Pongkemon01/zeabus-elec-hydrophone-frontend/Simulation/FilterGain.asc

C1: cap; 0.022µ; V=16 Irms=21.8m Rser=9.56706 Lser=0
C2: cap; 0.022µ; V=16 Irms=21.8m Rser=9.56706 Lser=0
C3: cap; 220p; V=16 Irms=459m Rser=0.256209 Lser=0
C4: polcap; 100µ; V=6.3 Irms=150m Rser=0.85 Lser=0 mfg="Nichicon" pn="UPL0J101MAH" type="Al electrolytic"
C5: cap; 10µ; V=25 Irms=8.06 Rser=0.00577565 Lser=0 mfg="KEMET" pn="C1210C106K3PAC" type="X5R"
C6: cap; 0.022µ; V=16 Irms=21.8m Rser=9.56706 Lser=0
C7: cap; 0.022µ; V=16 Irms=21.8m Rser=9.56706 Lser=0
C8: cap; 220p; V=16 Irms=459m Rser=0.256209 Lser=0
C9: cap; 150p; V=16 Irms=459m Rser=0.256209 Lser=0
C10: cap; 150p; V=16 Irms=459m Rser=0.256209 Lser=0
C11: cap; 0.022µ; V=16 Irms=21.8m Rser=9.56706 Lser=0
C12: cap; 0.022µ; V=16 Irms=21.8m Rser=9.56706 Lser=0
C13: cap; 220p; V=16 Irms=459m Rser=0.256209 Lser=0
C14: cap; 150p; V=16 Irms=459m Rser=0.256209 Lser=0
C15: cap; 150p; V=16 Irms=459m Rser=0.256209 Lser=0
C16: cap; 150p; V=16 Irms=459m Rser=0.256209 Lser=0
C17: cap; 150p; V=16 Irms=459m Rser=0.256209 Lser=0
C18: cap; 0.022µ; V=16 Irms=21.8m Rser=9.56706 Lser=0
C19: cap; 0.022µ; V=16 Irms=21.8m Rser=9.56706 Lser=0
C20: cap; 220p; V=16 Irms=459m Rser=0.256209 Lser=0
C21: cap; 150p; V=16 Irms=459m Rser=0.256209 Lser=0
C22: cap; 150p; V=16 Irms=459m Rser=0.256209 Lser=0
R1: res; 1K; tol=1 pwr=0.1
R2: res; 1K; tol=1 pwr=0.1
R3: res; 10K; tol=1 pwr=0.1
R4: res; 10K; tol=1 pwr=0.1
R5: res; 10K; tol=1 pwr=0.1
R6: res; 10K; tol=1 pwr=0.1
R7: res; 1K; tol=1 pwr=0.1
R8: res; 1K; tol=1 pwr=0.1
R9: res; 1K; tol=1 pwr=0.1
R10: res; 10K; tol=1 pwr=0.1
R11: res; 1K; tol=1 pwr=0.1
R12: res; 1K; tol=1 pwr=0.1
R13: res; 10K; tol=1 pwr=0.1
R14: res; 10K; tol=1 pwr=0.1
R15: res; 1K; tol=1 pwr=0.1
R16: res; 1K; tol=1 pwr=0.1
R17: res; 1K; tol=1 pwr=0.1
R18: res; 10K; tol=1 pwr=0.1
R19: res; 680; tol=1 pwr=0.1
R20: res; 1000K
R21: res; 1K; tol=1 pwr=0.1
R22: res; 1K; tol=1 pwr=0.1
R23: res; 10K; tol=1 pwr=0.1
R24: res; 10K; tol=1 pwr=0.1
R25: res; 1K; tol=1 pwr=0.1
R26: res; 1K; tol=1 pwr=0.1
R27: res; 680; tol=1 pwr=0.1
R28: res; 1000K
R29: res; 1K; tol=1 pwr=0.1
R30: res; 10K; tol=1 pwr=0.1
R31: res; 680; tol=1 pwr=0.1
R32: res; 1000K
R33: res; 1K; tol=1 pwr=0.1
R34: res; 1K; tol=1 pwr=0.1
R35: res; 10K; tol=1 pwr=0.1
R36: res; 10K; tol=1 pwr=0.1
R37: res; 1K; tol=1 pwr=0.1
R38: res; 1K; tol=1 pwr=0.1
R39: res; 1K; tol=1 pwr=0.1
R40: res; 10K; tol=1 pwr=0.1
R41: res; 680; tol=1 pwr=0.1
R42: res; 1000K
U1: AD8092
U2: AD8092
U3: AD8092
U4: AD8092
U5: AD8092
U6: AD8092
U7: AD8092
U8: AD8092
V1: voltage; 5
V2: voltage; ""; AC 1
V3: voltage; ""; AC 1
V4: voltage; ""; AC 1
V5: voltage; ""; AC 1
Named nets: 0, Vcc, Vref
.ac dec 100 1k 1000k
