Pongkemon01/zeabus-elec-hydrophone-frontend/zeabus-elec-hydrophone-frontend.kicad_pcb

## KiCad design zeabus-elec-hydrophone-frontend.kicad_pcb (2018-04-28)

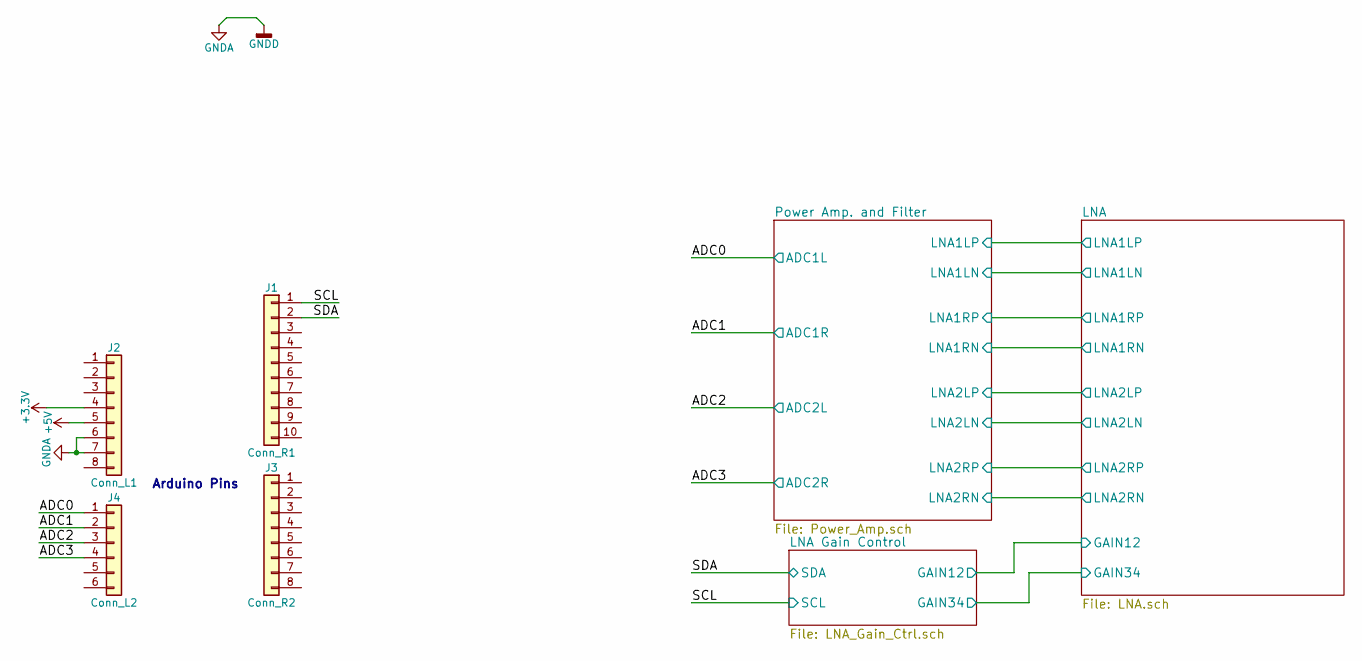
[picture p1: schematic zeabus-elec-hydrophone-frontend.sch, Main Sheet]

Parts:
J1: Conn_R1; Pin_Header_Straight_1x10_Pitch2.54mm
J2: Conn_L1; Pin_Header_Straight_1x08_Pitch2.54mm
J3: Conn_R2; Pin_Header_Straight_1x08_Pitch2.54mm
J4: Conn_L2; Pin_Header_Straight_1x06_Pitch2.54mm

Connections:
+3V3: J2.4; also elsewhere on the board
+5V: J2.5; also elsewhere on the board
/ADC0: J4.1; also elsewhere on the board
/ADC1: J4.2; also elsewhere on the board
/ADC2: J4.3; also elsewhere on the board
/ADC3: J4.4; also elsewhere on the board
/SCL: J1.1; also elsewhere on the board
/SDA: J1.2; also elsewhere on the board
GNDA: J2.6, J2.7; also elsewhere on the board

Notes on the sheet:
Arduino Pins

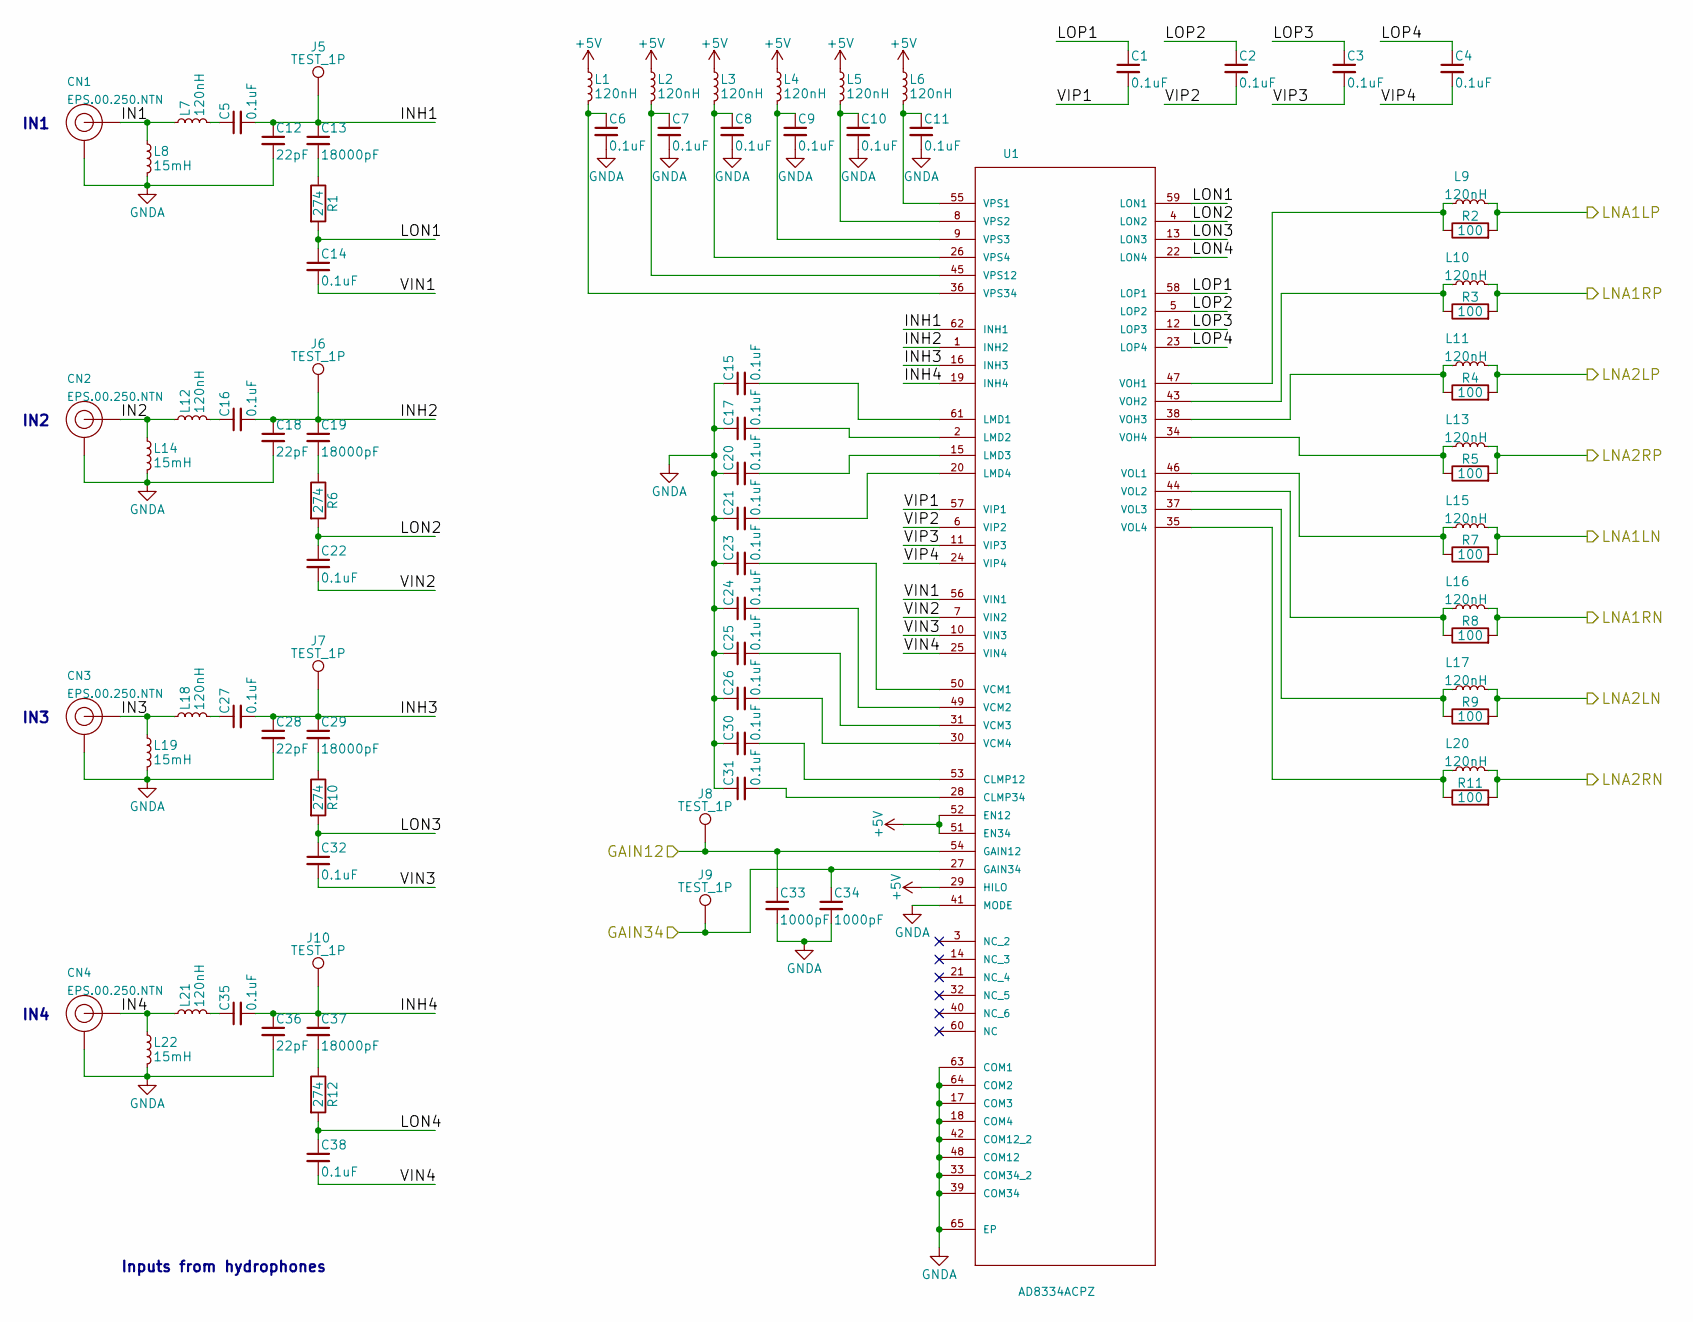
[picture p2: schematic LNA.sch]

Parts:
C1, C2, C3, C4, C5, C6, C7, C8, C9, C10, C11, C14, C15, C16, C17, C20, C21, C22, C23, C24, C25, C26, C27, C30, C31, C32, C35, C38: 0.1uF; C_0603_HandSoldering
C12, C18, C28, C36: 22pF; C_0603_HandSoldering
C13, C19, C29, C37: 18000pF; C_0603_HandSoldering
C33, C34: 1000pF; C_0603_HandSoldering
CN1, CN2, CN3, CN4: EPS.00.250.NTN; EPS-00-250
J5, J6, J7, J8, J9, J10: TEST_1P; Pin_Header_Straight_1x01_Pitch2.54mm
L1, L2, L3, L4, L5, L6, L7, L9, L10, L11, L12, L13, L15, L16, L17, L18, L20, L21: 120nH; L_0603_HandSoldering
L8, L14, L19, L22: 15mH; L-SDR0503
R1, R6, R10, R12: 274; R_0603_HandSoldering
R2, R3, R4, R5, R7, R8, R9, R11: 100; R_0603_HandSoldering
U1: AD8334ACPZ; QFN50P900X900X100-65N

Connections:
+5V: L1.1, L2.1, L3.1, L4.1, L5.1, L6.1, U1.29 (HILO), U1.51 (EN34), U1.52 (EN12); also elsewhere on the board
/LNA Gain Control/GAIN12: C33.1, J8.1, U1.54 (GAIN12); also elsewhere on the board
/LNA Gain Control/GAIN34: C34.1, J9.1, U1.27 (GAIN34); also elsewhere on the board
/LNA/IN1: CN1.1 (OUT), L7.1, L8.1
/LNA/IN2: CN2.1 (OUT), L12.1, L14.1
/LNA/IN3: CN3.1 (OUT), L18.1, L19.1
/LNA/IN4: CN4.1 (OUT), L21.1, L22.1
/LNA/INH1: C5.2, C12.1, C13.1, J5.1, U1.62 (INH1)
/LNA/INH2: C16.2, C18.1, C19.1, J6.1, U1.1 (INH2)
/LNA/INH3: C27.2, C28.1, C29.1, J7.1, U1.16 (INH3)
/LNA/INH4: C35.2, C36.1, C37.1, J10.1, U1.19 (INH4)
/LNA/LNA1LN: L15.2, R7.2; also elsewhere on the board
/LNA/LNA1LP: L9.2, R2.2; also elsewhere on the board
/LNA/LNA1RN: L16.2, R8.2; also elsewhere on the board
/LNA/LNA1RP: L10.2, R3.2; also elsewhere on the board
/LNA/LNA2LN: L17.2, R9.2; also elsewhere on the board
/LNA/LNA2LP: L11.2, R4.2; also elsewhere on the board
/LNA/LNA2RN: L20.2, R11.2; also elsewhere on the board
/LNA/LNA2RP: L13.2, R5.2; also elsewhere on the board
/LNA/LON1: C14.1, R1.2, U1.59 (LON1)
/LNA/LON2: C22.1, R6.2, U1.4 (LON2)
/LNA/LON3: C32.1, R10.2, U1.13 (LON3)
/LNA/LON4: C38.1, R12.2, U1.22 (LON4)
/LNA/LOP1: C1.1, U1.58 (LOP1)
/LNA/LOP2: C2.1, U1.5 (LOP2)
/LNA/LOP3: C3.1, U1.12 (LOP3)
/LNA/LOP4: C4.1, U1.23 (LOP4)
/LNA/VIN1: C14.2, U1.56 (VIN1)
/LNA/VIN2: C22.2, U1.7 (VIN2)
/LNA/VIN3: C32.2, U1.10 (VIN3)
/LNA/VIN4: C38.2, U1.25 (VIN4)
/LNA/VIP1: C1.2, U1.57 (VIP1)
/LNA/VIP2: C2.2, U1.6 (VIP2)
/LNA/VIP3: C3.2, U1.11 (VIP3)
/LNA/VIP4: C4.2, U1.24 (VIP4)
GNDA: C6.2, C7.2, C8.2, C9.2, C10.2, C11.2, C12.2, C15.1, C17.1, C18.2, C20.1, C21.1, C23.1, C24.1, C25.1, C26.1, C28.2, C30.1, C31.1, C33.2, C34.2, C36.2, CN1.2 (GND), CN1.3 (GND), CN1.4 (GND), CN1.5 (GND), CN2.2 (GND), CN2.3 (GND), CN2.4 (GND), CN2.5 (GND), CN3.2 (GND), CN3.3 (GND), CN3.4 (GND), CN3.5 (GND), CN4.2 (GND), CN4.3 (GND), CN4.4 (GND), CN4.5 (GND), L8.2, L14.2, L19.2, L22.2, U1.17 (COM3), U1.18 (COM4), U1.33 (COM34_2), U1.39 (COM34), U1.41 (MODE), U1.42 (COM12_2), U1.48 (COM12), U1.63 (COM1), U1.64 (COM2), U1.65 (EP); also elsewhere on the board
unnamed: C5.1, L7.2
unnamed: C6.1, L1.2, U1.36 (VPS34)
unnamed: C7.1, L2.2, U1.45 (VPS12)
unnamed: C8.1, L3.2, U1.26 (VPS4)
unnamed: C9.1, L4.2, U1.9 (VPS3)
unnamed: C10.1, L5.2, U1.8 (VPS2)
unnamed: C11.1, L6.2, U1.55 (VPS1)
unnamed: C13.2, R1.1
unnamed: C15.2, U1.61 (LMD1)
unnamed: C16.1, L12.2
unnamed: C17.2, U1.2 (LMD2)
unnamed: C19.2, R6.1
unnamed: C20.2, U1.15 (LMD3)
unnamed: C21.2, U1.20 (LMD4)
unnamed: C23.2, U1.50 (VCM1)
unnamed: C24.2, U1.49 (VCM2)
unnamed: C25.2, U1.31 (VCM3)
unnamed: C26.2, U1.30 (VCM4)
unnamed: C27.1, L18.2
unnamed: C29.2, R10.1
unnamed: C30.2, U1.53 (CLMP12)
unnamed: C31.2, U1.28 (CLMP34)
unnamed: C35.1, L21.2
unnamed: C37.2, R12.1
unnamed: L9.1, R2.1, U1.47 (VOH1)
unnamed: L10.1, R3.1, U1.43 (VOH2)
unnamed: L11.1, R4.1, U1.38 (VOH3)
unnamed: L13.1, R5.1, U1.34 (VOH4)
unnamed: L15.1, R7.1, U1.46 (VOL1)
unnamed: L16.1, R8.1, U1.44 (VOL2)
unnamed: L17.1, R9.1, U1.37 (VOL3)
unnamed: L20.1, R11.1, U1.35 (VOL4)

Notes on the sheet:
IN1
IN2
IN3
IN4
Inputs from hydrophones

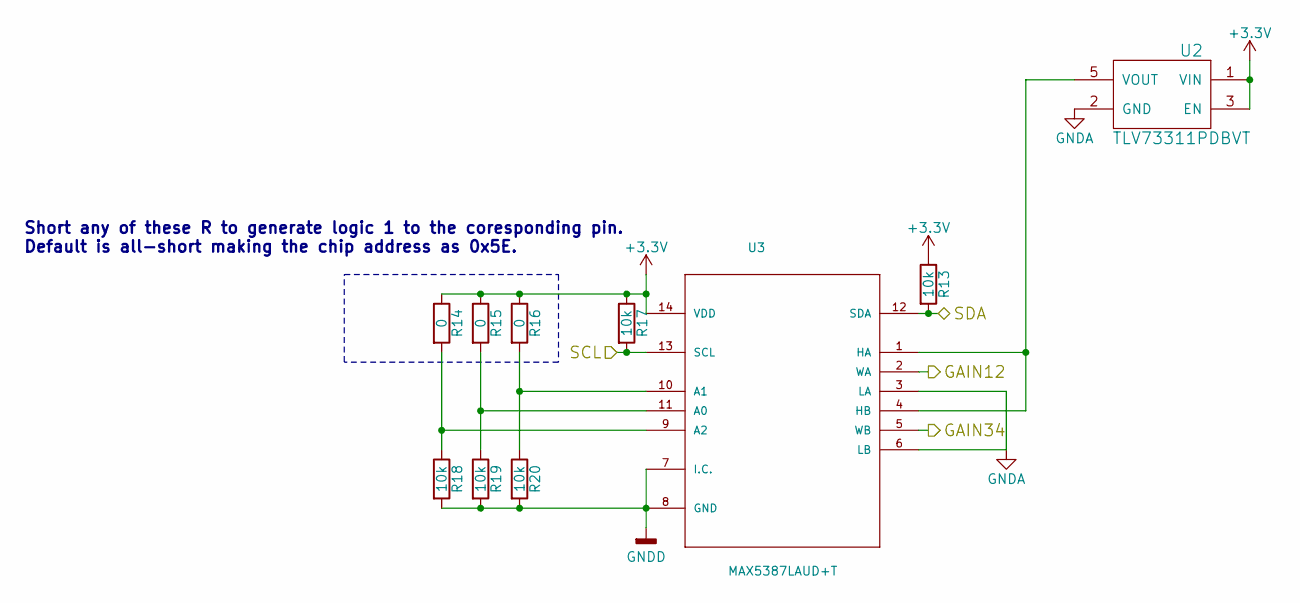
[picture p3: schematic LNA_Gain_Ctrl.sch, LNA Gain Controller]

Parts:
R13, R17, R18, R19, R20: 10k; R_0603_HandSoldering
R14, R15, R16: 0; R_0603_HandSoldering
U2: TLV73311PDBVT; SOT-23-5
U3: MAX5387LAUD+T; TSSOP-14_4.4x5mm_Pitch0.65mm

Connections:
+3V3: R13.1, R14.1, R15.1, R16.1, R17.1, U2.1 (VIN), U2.3 (EN), U3.14 (VDD); also elsewhere on the board
/LNA Gain Control/GAIN12: U3.2 (WA); also elsewhere on the board
/LNA Gain Control/GAIN34: U3.5 (WB); also elsewhere on the board
/SCL: R17.2, U3.13 (SCL); also elsewhere on the board
/SDA: R13.2, U3.12 (SDA); also elsewhere on the board
GNDA: R18.2, R19.2, R20.2, U2.2 (GND), U3.3 (LA), U3.6 (LB), U3.7 (I.C.), U3.8 (GND); also elsewhere on the board
unnamed: R14.2, R18.1, U3.9 (A2)
unnamed: R15.2, R19.1, U3.11 (A0)
unnamed: R16.2, R20.1, U3.10 (A1)
unnamed: U2.5 (VOUT), U3.1 (HA), U3.4 (HB)

Notes on the sheet:
Short any of these R to generate logic 1 to the coresponding pin. Default is all-short making the chip address as 0x5E.

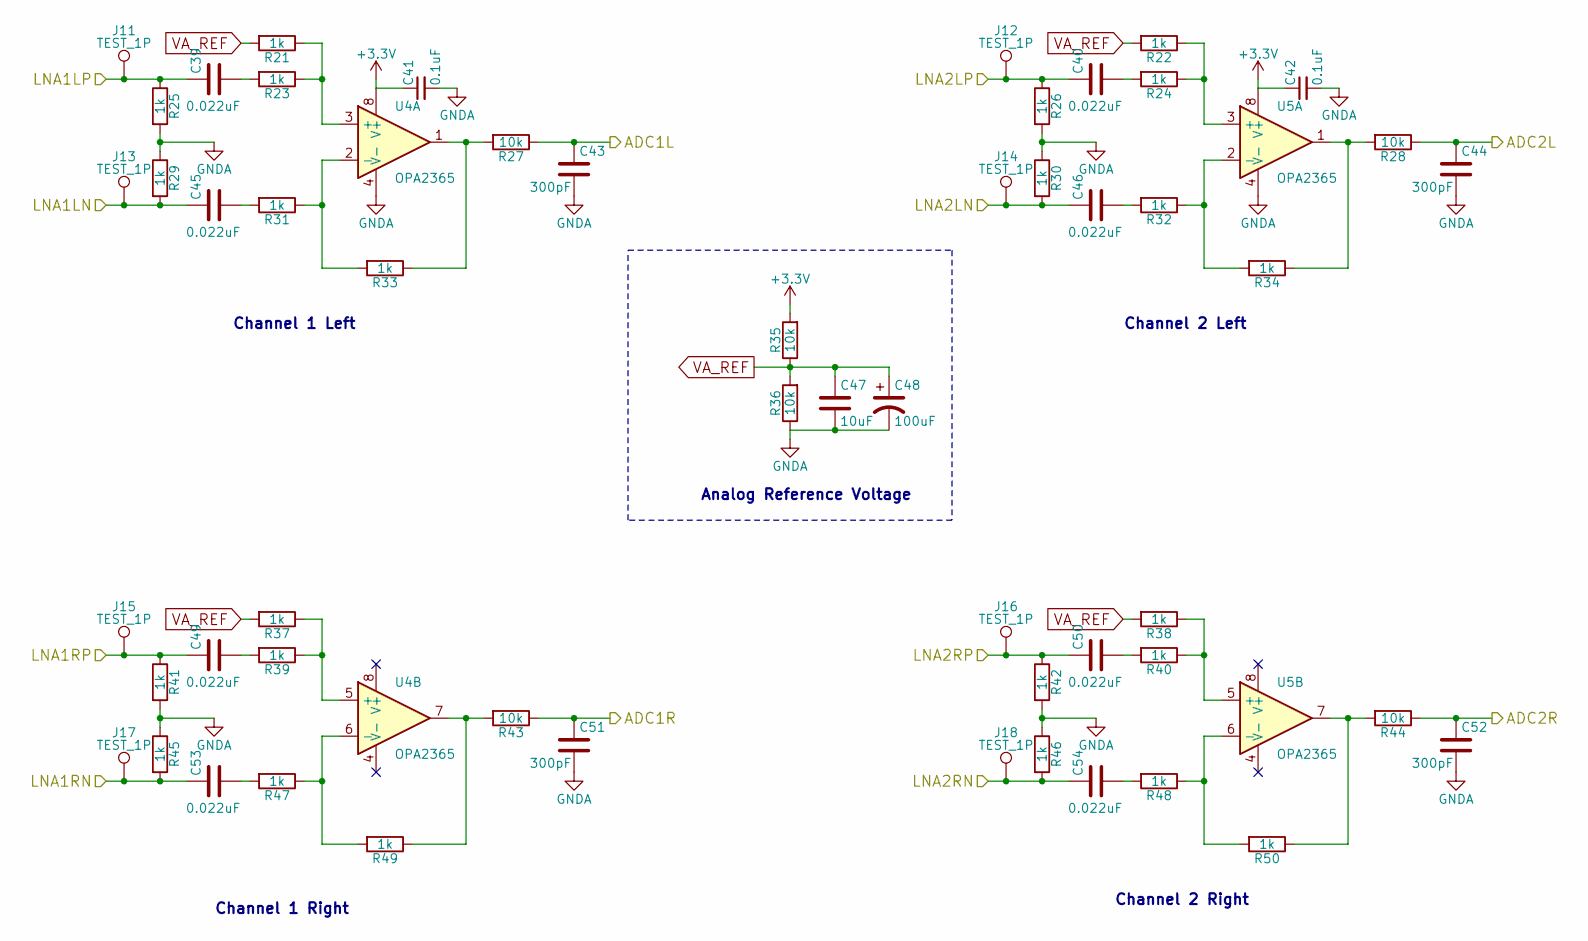
[picture p4: schematic Power_Amp.sch]

Parts:
C39, C40, C45, C46, C49, C50, C53, C54: 0.022uF; C_0603_HandSoldering
C41, C42: 0.1uF; C_0603_HandSoldering
C43, C44, C51, C52: 300pF; C_0603_HandSoldering
C47: 10uF; C_0805_HandSoldering
C48: 100uF; C_1210_HandSoldering
J11, J12, J13, J14, J15, J16, J17, J18: TEST_1P; Pin_Header_Straight_1x01_Pitch2.54mm
R21, R22, R23, R24, R25, R26, R29, R30, R31, R32, R33, R34, R37, R38, R39, R40, R41, R42, R45, R46, R47, R48, R49, R50: 1k; R_0603_HandSoldering
R27, R28, R35, R36, R43, R44: 10k; R_0603_HandSoldering
U4, U5: OPA2365; SOIC-8_3.9x4.9mm_Pitch1.27mm

Connections:
+3V3: C41.1, C42.1, R35.2, U4.8 (V+), U5.8 (V+); also elsewhere on the board
/ADC0: C43.1, R27.1; also elsewhere on the board
/ADC1: C51.1, R43.1; also elsewhere on the board
/ADC2: C44.1, R28.1; also elsewhere on the board
/ADC3: C52.1, R44.1; also elsewhere on the board
/LNA/LNA1LN: C45.1, J13.1, R29.2; also elsewhere on the board
/LNA/LNA1LP: C39.1, J11.1, R25.1; also elsewhere on the board
/LNA/LNA1RN: C53.1, J17.1, R45.2; also elsewhere on the board
/LNA/LNA1RP: C49.1, J15.1, R41.1; also elsewhere on the board
/LNA/LNA2LN: C46.1, J14.1, R30.2; also elsewhere on the board
/LNA/LNA2LP: C40.1, J12.1, R26.1; also elsewhere on the board
/LNA/LNA2RN: C54.1, J18.1, R46.2; also elsewhere on the board
/LNA/LNA2RP: C50.1, J16.1, R42.1; also elsewhere on the board
GNDA: C41.2, C42.2, C43.2, C44.2, C47.2, C48.2, C51.2, C52.2, R25.2, R26.2, R29.1, R30.1, R36.1, R41.2, R42.2, R45.1, R46.1, U4.4 (V-), U5.4 (V-); also elsewhere on the board
unnamed: C39.2, R23.2
unnamed: C40.2, R24.2
unnamed: C45.2, R31.2
unnamed: C46.2, R32.2
unnamed: C49.2, R39.2
unnamed: C50.2, R40.2
unnamed: C53.2, R47.2
unnamed: C54.2, R48.2
unnamed: R21.1, R23.1, U4.3 (+)
unnamed: R22.1, R24.1, U5.3 (+)
unnamed: R27.2, R33.1, U4.1
unnamed: R28.2, R34.1, U5.1
unnamed: R31.1, R33.2, U4.2 (-)
unnamed: R32.1, R34.2, U5.2 (-)
unnamed: R37.1, R39.1, U4.5 (+)
unnamed: R38.1, R40.1, U5.5 (+)
unnamed: R43.2, R49.1, U4.7
unnamed: R44.2, R50.1, U5.7
unnamed: R47.1, R49.2, U4.6 (-)
unnamed: R48.1, R50.2, U5.6 (-)
VA_REF: C47.1, C48.1, R21.2, R22.2, R35.1, R36.2, R37.2, R38.2

Notes on the sheet:
Analog Reference Voltage
Channel 1 Left
Channel 1 Right
Channel 2 Left
Channel 2 Right

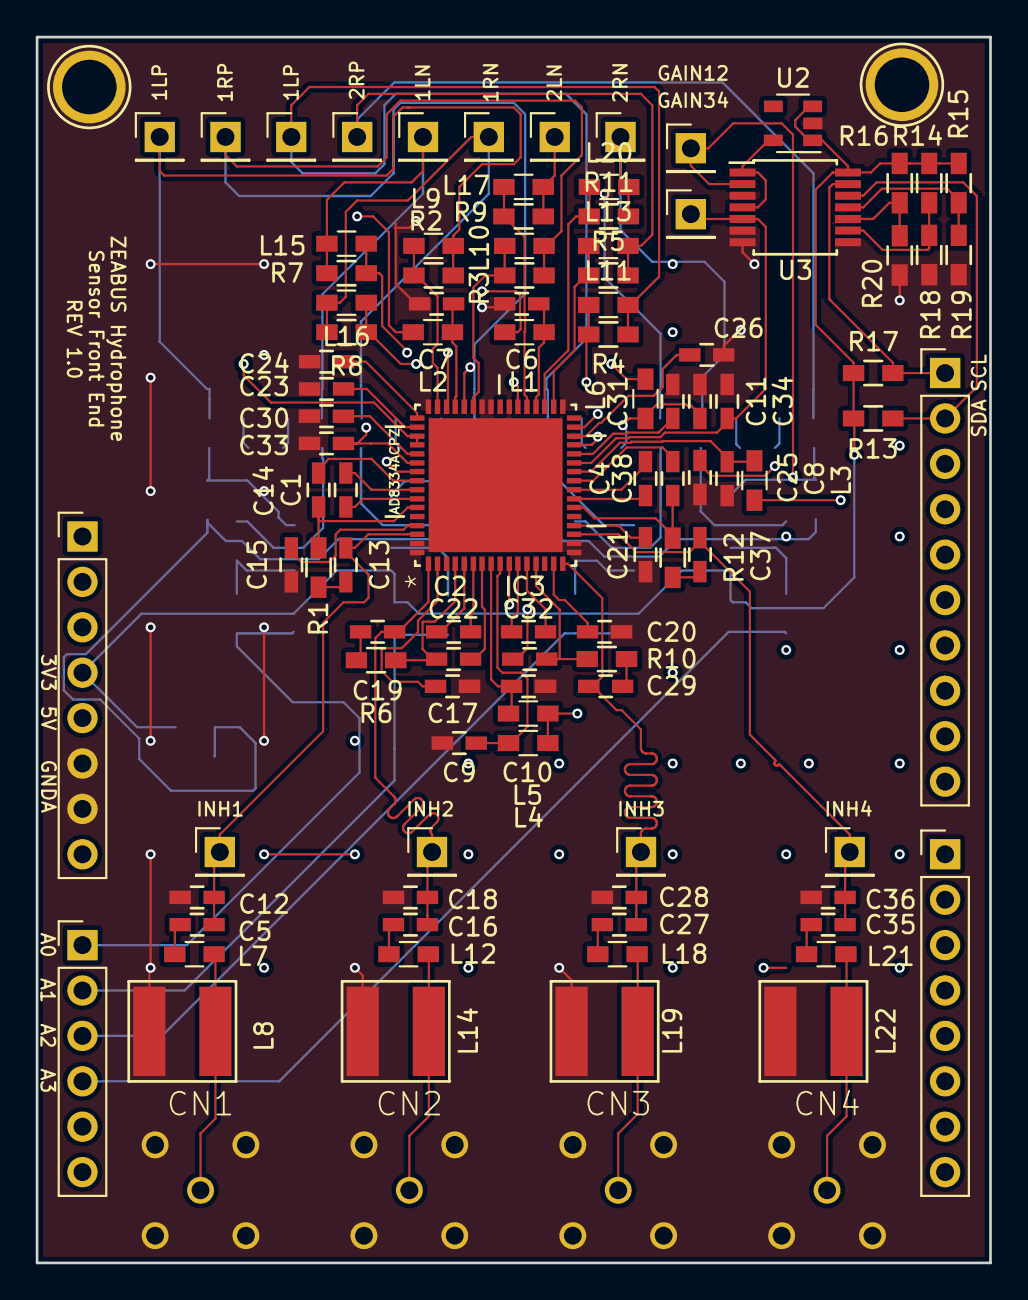
[picture p5: board zeabus-elec-hydrophone-frontend.kicad_pcb from above]

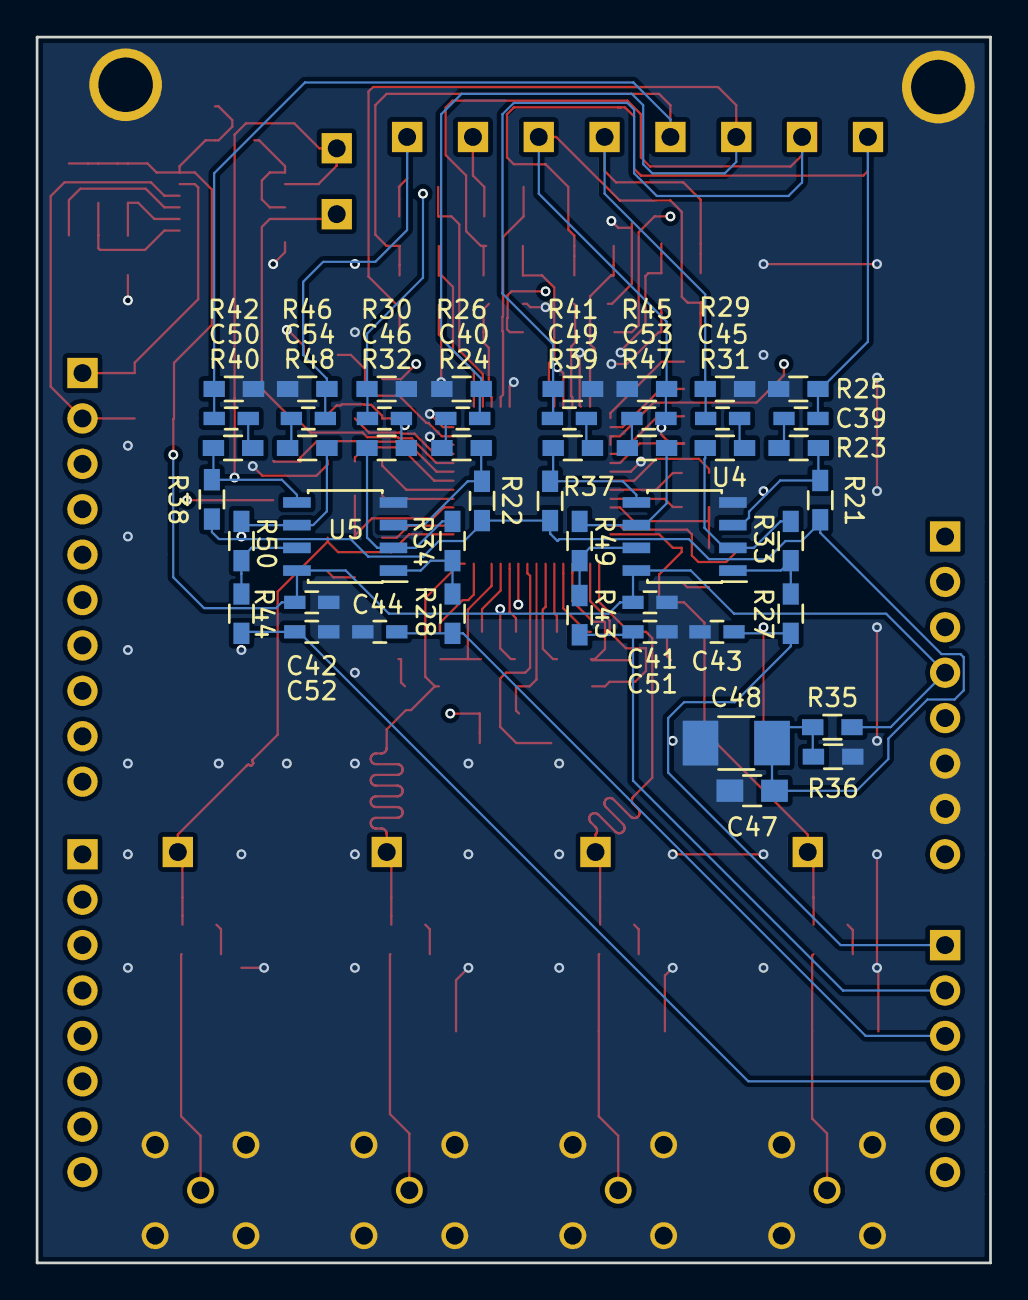
[picture p6: board zeabus-elec-hydrophone-frontend.kicad_pcb from below]

Board: 4 copper layers, 53.3 x 68.6 mm, 153 parts (48 on the bottom side), 100 nets.
