Pongkemon01/zeabus-elec-hydrophone-frontend/(commit log)

2018-04-19 First commit with schematic
    [LNA.sch, LNA_Gain_Ctrl.sch, Power_Amp.sch, zeabus-elec-hydrophone-frontend.kicad_pcb, zeabus-elec-hydrophone-frontend.sch]
2018-04-19 Change OPAMP number to OPA2365
    [Power_Amp.sch]
2018-04-22 Bug fixed 1
    [LNA.sch, zeabus-elec-hydrophone-frontend.sch]
2018-04-22 add LNA Gain Test Point
    [LNA.sch, LNA_Gain_Ctrl.sch, Power_Amp.sch, zeabus-elec-hydrophone-frontend.sch]
2018-04-22 add BOM file
2018-04-22 Assigned footprint for dimension checking
    [LNA.sch, LNA_Gain_Ctrl.sch, Power_Amp.sch, zeabus-elec-hydrophone-frontend.kicad_pcb, zeabus-elec-hydrophone-frontend.sch]
2018-04-27 First released
    [LNA_Gain_Ctrl.sch, Power_Amp.sch, zeabus-elec-hydrophone-frontend.kicad_pcb]
2018-04-28 edit layout and silkscreen
    [zeabus-elec-hydrophone-frontend.kicad_pcb]
2018-04-28 Finished the PCB plus adding some stitching vias
    [zeabus-elec-hydrophone-frontend.kicad_pcb]
2018-04-28 add gerber file and sent to pcbway
    [zeabus-elec-hydrophone-frontend-B.Cu.gbl, zeabus-elec-hydrophone-frontend-B.Mask.gbs, zeabus-elec-hydrophone-frontend-B.Paste.gbp, zeabus-elec-hydrophone-frontend-B.SilkS.gbo, zeabus-elec-hydrophone-frontend-Edge.Cuts.gm1, zeabus-elec-hydrophone-frontend-F.Cu.gtl, zeabus-elec-hydrophone-frontend-F.Mask.gts, zeabus-elec-hydrophone-frontend-F.Paste.gtp]
